vmware001/embedded_system_design_smart_watch/系统设计文档.docx

# 基于STM32F103C8T6的智能手表设计 — 系统设计文档

# 一、物料到位情况

截至本报告提交日，本组物料到位情况如下：

序号 | 器件名称 | 数量 | 到位状态 | 备注
1 | STM32F103C8T6最小系统板 | 1 | 已到位 | 已有，含板载AMS1117-3.3V稳压
2 | ST-Link V2调试器 | 1 | 已到位 | 已有
3 | 1.3寸 OLED（SSH1106，I2C，4针） | 2 | 已采购/在途 | 预计7月1日到货，1用1备
4 | GY-521 MPU6050模块 | 2 | 已采购/在途 | 预计7月1日到货，1用1备
5 | TP4056 Type-C充电模块 | 2 | 已采购/在途 | 预计7月1日到货
6 | 602040 锂聚合物电池 3.7V 400mAh | 2 | 已采购/在途 | 预计7月1日到货
7 | EC11旋转编码器（带开关） | 2 | 已采购/在途 | 预计7月1日到货，1用1备
8 | HC-05蓝牙模块（带底板） | 2 | 已采购/在途 | 预计7月1日到货，仅安卓支持，1用1备
9 | 1/4W直插电阻包（30种/600个） | 1 | 已采购/在途 | 预计7月1日到货，含4.7K/10K/1K/220Ω
10 | 瓷片电容104（100nF，100个） | 1 | 已采购/在途 | 预计7月1日到货
11 | 独石电容10uF（5个/份） | 3 | 已采购/在途 | 预计7月1日到货，共15个
12 | 6×6×5mm直插轻触按键 | 1 | 已采购/在途 | 预计7月1日到货，通常1份50个
13 | 1N5819肖特基二极管（直插，50只） | 1 | 已采购/在途 | 预计7月1日到货，电池防反接
14 | CH340C USB转TTL串口模块 | 2 | 已采购/在途 | 预计7月1日到货，串口调试
15 | 5×7cm 洞洞板（2张/份） | 2 | 已采购/在途 | 预计7月1日到货，共4张
16 | 示波器、万用表、面包板、跳线等 | 1 | 已到位 | 已有
17 | 18650电池、电烙铁、锡膏、无铅焊锡 | 1 | 已到位 | 已有，18650作为备用调试电源

# 二、系统方案设计

2.1 总体架构

系统采用STM32F103C8T6作为主控MCU，以FreeRTOS作为实时操作系统内核，实现多任务并行调度。系统架构分为四层：硬件层（MCU、传感器、显示、电源、通信）、驱动层（I2C、GPIO、UART、定时器、PWM）、中间件层（FreeRTOS任务调度、内存管理、任务间通信）和应用层（UI显示、时间管理、传感器采集、蓝牙通信、计步算法）。

2.2 硬件框图

硬件系统组成：

• 主控：STM32F103C8T6（72MHz Cortex-M3，64KB Flash，20KB RAM）

• 显示：1.3寸 OLED，I2C接口（SCL→PB6，SDA→PB7），SSH1106驱动，128×64分辨率

• 传感器：MPU6050，I2C接口（与OLED共享I2C总线），地址0x68（AD0接地），提供3轴加速度+3轴陀螺仪数据

• 电源：3.7V锂电池 → TP4056充电管理 → 系统板5V输入 → 板载AMS1117-3.3V稳压至3.3V → 系统供电

• 输入：EC11旋转编码器（A相→PA0，B相→PA1，按键→PA2），用于菜单切换与选择

• 通信：HC-05蓝牙模块（UART1：TX→PA9，RX→PA10），9600波特率，与安卓手机同步数据

• 开关：直插轻触开关接系统板复位引脚或自定义GPIO，用于一键开机与菜单确认

2.3 软件流程图

软件系统启动流程：系统上电 → 初始化时钟/GPIO/外设 → 初始化I2C总线 → 初始化OLED与MPU6050 → 初始化FreeRTOS → 创建任务（UI任务、时间管理任务、传感器采集任务、蓝牙通信任务） → 启动调度器 → 各任务按优先级运行。

主程序循环由FreeRTOS调度器管理，高优先级任务（如UI刷新）可抢占低优先级任务（如传感器数据采集）。任务间通过消息队列和信号量进行同步与数据传递。

# 三、详细设计文档

3.1 硬件部分

（1）I2C接口电路：OLED与MPU6050共享I2C1总线，SCL接PB6，SDA接PB7。I2C总线需外接上拉电阻（4.7KΩ）至3.3V。STM32F103C8T6的I2C1支持标准模式（100kHz）和快速模式（400kHz），本项目采用400kHz快速模式。

（2）电源电路：3.7V锂电池（标称4.2V满电）经TP4056模块充电管理，输出直接接入STM32最小系统板的5V输入端，由系统板自带的AMS1117-3.3V稳压芯片降压至3.3V，供MCU及所有外设使用。TP4056输入为Type-C 5V，充电电流默认约1A。面包板调试阶段可直接通过USB线给系统板供电，系统板3.3V输出引脚为外设供电。电池供电时在TP4056输出端串联1N5819肖特基二极管，实现电池防反接保护。

（3）一键开机电路：采用直插轻触开关直接接入系统板复位引脚（NRST）或自定义GPIO（如PA3）。按下开关时系统复位或触发GPIO中断，实现开机唤醒；配合软件逻辑，可实现长按关机功能。此方案简洁可靠，无需额外MOS管驱动电路。

（4）旋转编码器接口：EC11的A、B相输出接PA0、PA1（配置为外部中断输入，上升沿/下降沿触发），按键接PA2（配置为GPIO输入，内部上拉）。通过中断服务程序检测A/B相的相位差判断旋转方向，按键用于菜单确认。

（5）蓝牙模块接口：HC-05的TXD接PA10（USART1_RX），RXD接PA9（USART1_TX），EN接PA4（用于AT模式配置）。波特率默认9600，支持蓝牙串口透传。

3.2 软件部分

（1）模块划分：软件系统划分为以下模块：

• bsp_i2c.c / bsp_i2c.h：I2C底层驱动，封装读写函数

• bsp_oled.c / bsp_oled.h：SSH1106 OLED驱动，提供清屏、画点、画线、显示字符/字符串、显示数字等接口

• bsp_mpu6050.c / bsp_mpu6050.h：MPU6050驱动，初始化DMP或直接读取原始加速度/陀螺仪数据

• bsp_encoder.c / bsp_encoder.h：旋转编码器驱动，处理外部中断，提供旋转方向与按键事件

• bsp_bluetooth.c / bsp_bluetooth.h：HC-05蓝牙串口驱动，封装数据发送/接收

• app_ui.c / app_ui.h：UI显示任务，管理OLED页面（时间页面、传感器数据页面、菜单页面）

• app_time.c / app_time.h：时间管理任务，基于SysTick或通用定时器产生秒中断，维护软件RTC

• app_sensor.c / app_sensor.h：传感器采集任务，定期读取MPU6050数据，实现计步算法

• app_bluetooth.c / app_bluetooth.h：蓝牙通信任务，处理数据同步与指令接收

（2）关键算法描述：

• 时间维护算法：使用STM32的通用定时器TIM2（或SysTick）配置为1秒中断。每次中断将软件RTC的秒计数器加1，并换算为时/分/秒格式。时间初始值可在菜单中设置。

• 计步算法：基于MPU6050的加速度计Z轴数据，采用动态阈值法。检测加速度波形的波峰与波谷，当相邻波峰/波谷差值超过动态阈值且时间间隔在合理范围（0.2s~2s）内时，判定为有效步数。动态阈值根据最近若干步的峰值自适应更新。

（3）外设配置方案：

• I2C1：SCL=PB6，SDA=PB7，Fast-mode（400kHz），使用STM32 HAL库或寄存器直接操作

• USART1：TX=PA9，RX=PA10，波特率9600，用于HC-05蓝牙通信

• GPIO：PA0/PA1/PA2用于EC11编码器，PA3预留用于电源控制或按键中断，PA4用于HC-05 EN引脚

• TIM2：配置为1秒定时中断，用于软件RTC

（4）FreeRTOS任务划分：

• Task_UI：优先级3（最高），周期100ms，负责OLED界面刷新与菜单响应。阻塞等待编码器事件队列或页面切换信号量。

• Task_Time：优先级2，周期1000ms，负责维护软件RTC，更新时间数据结构。通过消息队列向Task_UI发送时间数据。

• Task_Sensor：优先级2，周期50ms，负责读取MPU6050加速度数据，执行计步算法，将步数与姿态数据通过消息队列发送给Task_UI。

• Task_Bluetooth：优先级1，事件驱动，监听USART1接收中断，解析蓝牙指令，将数据同步至手机或接收手机控制命令。

任务间通信：使用FreeRTOS消息队列（Queue）传递传感器数据和步数；使用二值信号量（Semaphore）同步编码器中断事件；使用互斥量（Mutex）保护共享的OLED I2C总线访问。

# 四、进度汇报

4.1 当前完成情况

• 已完成：项目计划书编写、物料采购下单、系统方案初步设计、FreeRTOS源码下载与工程框架搭建。

• 进行中：等待物料到货，准备硬件搭建；同时预研MPU6050 DMP库和OLED驱动代码。

• 未开始：硬件焊接、软件驱动编写、多任务集成调试。

4.2 后续工作计划

• 7月1日：物料到货，完成面包板硬件搭建，点亮OLED，确认MPU6050 I2C通信正常。

• 7月3日：完成FreeRTOS移植，创建各任务框架，实现时间显示与传感器数据读取。

• 7月5日：实现旋转编码器菜单切换、蓝牙通信基本功能。

• 7月6日：中期检查，提交中期检查报告，演示基本功能。

• 7月7日~8日：实现计步算法、数据记录，完成洞洞板焊接与系统联调。

• 7月9日：第一次验收，演示全部功能。

• 7月9日晚~10日：根据教师意见修改，完成最终验收。

基于STM32F103C8T6的智能手表设计 — 系统设计文档
