vmware001/embedded_system_design_smart_watch/项目计划书.docx

# 基于STM32F103C8T6的智能手表设计 — 项目计划书

# 一、项目概述

本项目为《2026嵌入式系统课程设计》第一类题目（题目2）：基于STM32F103C8T6的智能手表设计。项目采用STM32F103C8T6作为主控MCU，利用FreeRTOS实时操作系统实现多任务管理，通过I2C总线连接1.3寸OLED显示屏和MPU6050陀螺仪/加速度计，实现时间显示、传感器数据采集与界面显示。电源部分采用3.7V锂电池供电，经LDO稳压至3.3V，并配备TP4056充电管理电路。

项目目标：完成智能手表的硬件电路设计与软件系统开发，实现时间显示、传感器数据读取、OLED界面显示等基本功能；在此基础上，扩展旋转编码器多级菜单、蓝牙与手机数据同步等高级功能，争取达到“良好”及以上等级。

# 二、工作计划

项目从选题到最终验收，共约12天，划分为以下阶段：

阶段 | 主要工作内容 | 截止时间/里程碑
阶段1：选题与计划 | 完成选题，编写项目计划书 | 2026-06-30 9:00
阶段2：硬件采购与搭建 | 完成所有物料采购，搭建面包板原型电路 | 2026-07-01
阶段3：系统设计 | 编写系统设计文档，完成系统架构与详细设计 | 2026-07-02 9:00
阶段4：软件开发 | 移植FreeRTOS，编写I2C/OLED/MPU6050驱动，实现时间显示与传感器读取 | 2026-07-05
阶段5：扩展功能开发 | 实现旋转编码器菜单、蓝牙通信、计步算法 | 2026-07-07
阶段6：硬件焊接与集成 | 洞洞板焊接，整合外壳，完成系统联调 | 2026-07-08
阶段7：测试与验收 | 功能测试、性能优化，准备第一次验收 | 2026-07-09 9:00
阶段8：改进与最终验收 | 根据第一次验收意见修改，完成最终验收 | 2026-07-10 9:00

# 三、时间安排与分工

项目组成员投入时间及分工协调如下：

成员 | 可投入时间 | 负责模块 | 具体职责
成员A | 全天（约8h/天） | 硬件设计 | 电路设计、物料采购、洞洞板焊接、电源调试
成员B | 全天（约8h/天） | 软件开发 | FreeRTOS移植、驱动开发、传感器算法、界面逻辑
成员C（如有） | 半天（约4h/天） | 测试与文档 | 功能测试、蓝牙上位机设计、报告撰写

# 四、物料采购计划

根据题目要求及现有物料情况，尚需采购以下器件。本组已拥有电脑、STM32F103C8T6最小系统板、ST-Link调试器、示波器、万用表、面包板、跳线（公对母/母对母/公对公）、18650锂电池、电烙铁、锡膏、锡浆、无铅焊锡等基础设备。

需采购物料总成本预估约100~150元。其中核心器件约60~80元，扩展器件约30~40元，耗材约30~40元。所有器件均为直插或成品模块，面包板可直接搭建调试，无需额外设计PCB。建议统一在淘宝下单，预计2~3天内到货。

类别 | 器件 | 数量 | 单价(元) | 采购渠道 | 用途
核心器件 | 1.3寸 OLED显示屏（SSH1106，I2C，4针） | 2 | ~21 | 淘宝 | 时间/传感器显示
核心器件 | GY-521 MPU6050 模块（I2C，6轴） | 2 | ~13 | 淘宝 | 姿态/计步传感器
核心器件 | TP4056 Type-C 锂电池充电模块 | 2 | ~4.5 | 淘宝 | 锂电池充电管理
核心器件 | 3.7V 锂聚合物电池（602040，400mAh） | 2 | ~5 | 淘宝 | 手表电源
扩展器件 | EC11 旋转编码器（带开关，梅花柄15mm） | 2 | ~2.8 | 淘宝 | 菜单切换/确认
扩展器件 | HC-05 蓝牙串口模块（带底板，6针） | 2 | ~14 | 淘宝 | 手机数据同步（仅安卓）
耗材/工具 | 1/4W 直插金属膜电阻包（30种/600个） | 1 | ~9 | 淘宝 | I2C上拉/限流/分压
耗材/工具 | 瓷片电容 104（100nF，100个/包） | 1 | ~2 | 淘宝 | 去耦/滤波
耗材/工具 | 独石电容 106（10uF，5个/包） | 3 | ~2.2 | 淘宝 | 滤波/储能
耗材/工具 | 6×6×5mm 直插轻触按键 | 1 | ~2.2 | 淘宝 | 开机/功能按键
耗材/工具 | 1N5819 肖特基二极管（直插，50只） | 1 | ~4.2 | 淘宝 | 电池防反接保护
耗材/工具 | CH340C USB转TTL 串口模块 | 2 | ~7.8 | 淘宝 | 串口调试日志打印
耗材/工具 | 5×7cm 洞洞板（绿油单面，2张/包） | 2 | ~2 | 淘宝 | 焊接成品电路
已有物料 | STM32F103C8T6 最小系统板 | 1 | — | — | 主控MCU
已有物料 | ST-Link V2 调试器 | 1 | — | — | 程序烧录
已有物料 | 示波器、万用表、面包板、跳线等 | 1 | — | — | 调试/搭建
已有物料 | 18650 锂电池、电烙铁、锡膏、无铅焊锡 | 1 | — | — | 电源/焊接工具

# 五、风险与应对措施

1. 物料延迟风险：部分模块（如OLED、MPU6050）若采购延迟，将直接影响硬件搭建进度。应对措施：优先在本地电子市场或京东自营购买，预留1天缓冲时间。

2. 技术难点风险：FreeRTOS多任务调度可能出现死锁或优先级反转；MPU6050计步算法需要调试。应对措施：先实现单任务驱动，再逐步集成；计步算法先采用简单阈值法，后续优化。

3. 蓝牙兼容性问题：HC-05为经典蓝牙2.0，仅支持安卓手机连接，不支持iPhone及Windows电脑蓝牙。应对措施：提前准备安卓测试手机，并了解蓝牙模块AT指令配置。

4. 电池续航问题：18650电池体积较大，不适合手表佩戴；若使用602040小电池，容量有限。应对措施：主用602040锂聚合物电池作为演示电源，18650作为备用调试电源。

基于STM32F103C8T6的智能手表设计 — 项目计划书
