vmware001/embedded_system_design_smart_watch/面包板接线图.png

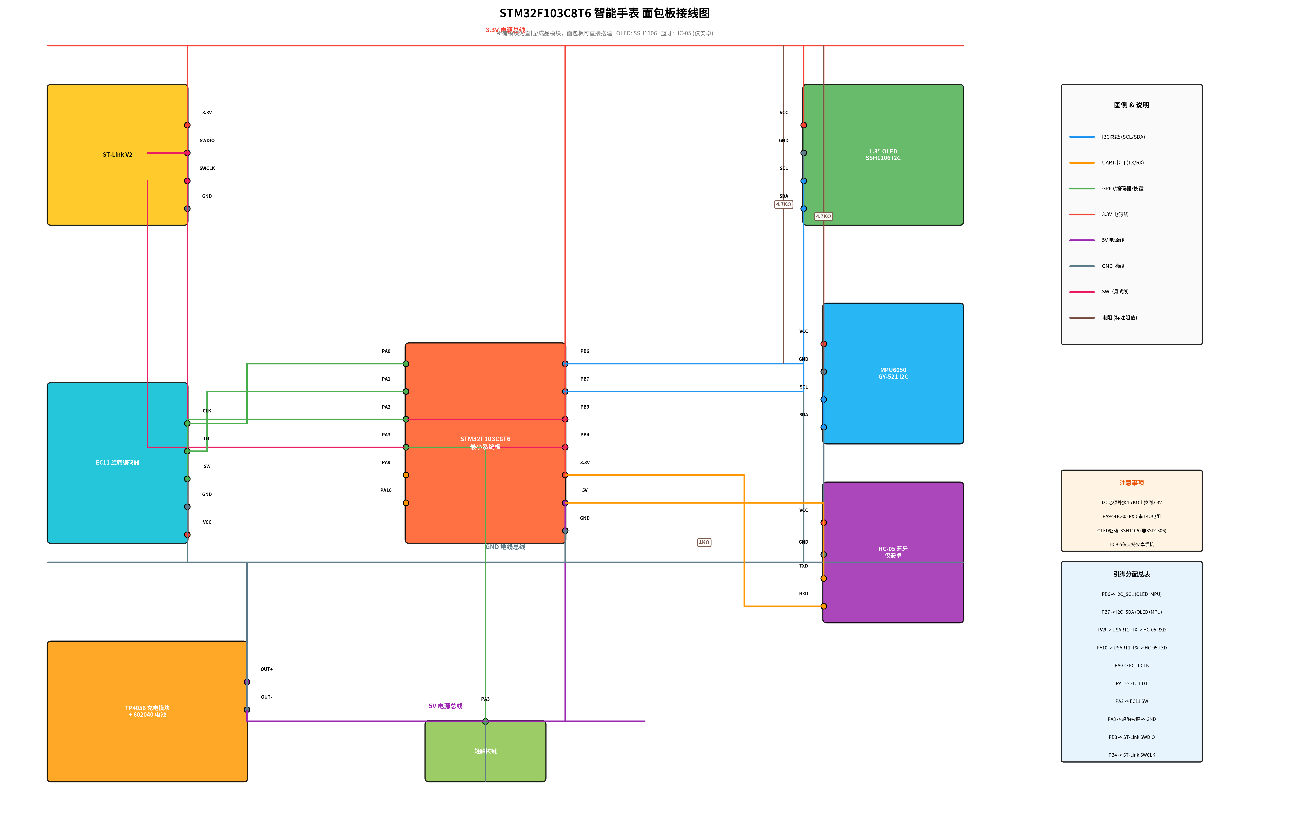
面包板接线图.png
