vmware001/embedded_system_design_smart_watch/project/project.ioc

Mcu.UserName=STM32F103C8Tx
PA0-WKUP.Signal=GPIO_Input
PA1.Signal=GPIO_Input
PA10.Signal=USART1_RX
PA13.Signal=SYS_JTMS-SWDIO
PA14.Signal=SYS_JTCK-SWCLK
PA2.Signal=GPIO_Input
PA3.Signal=GPIO_Input
PA9.Signal=USART1_TX
PB6.Signal=I2C1_SCL
PB7.Signal=I2C1_SDA
