vmware001/embedded_system_design_smart_watch/(commit log)

2026-07-08 Initial commit: Smart Watch project v35
    - STM32F103 + MPU6050 + OLED + BLE pedometer
    - Optimized step counter (eliminate sqrtf, O(1) moving avg, auto-calibration)
    - 5-page UI: Home, Steps, Info, Bluetooth, Stopwatch
    - BLE control via phone app (ble_control.py)
    - Moved obsolete test scripts to trash/
2026-07-08 docs: 添加详细 README.md
2026-07-08 docs: 完善 README — 电路接线、FIR滤波器数学推导、GPLv3.0许可证、移除待办列表
2026-07-08 docs: 详细解释 HC-05 230 字节缓冲 Bug 及 workaround
